Famoto/fetchbadge/case/preview.png

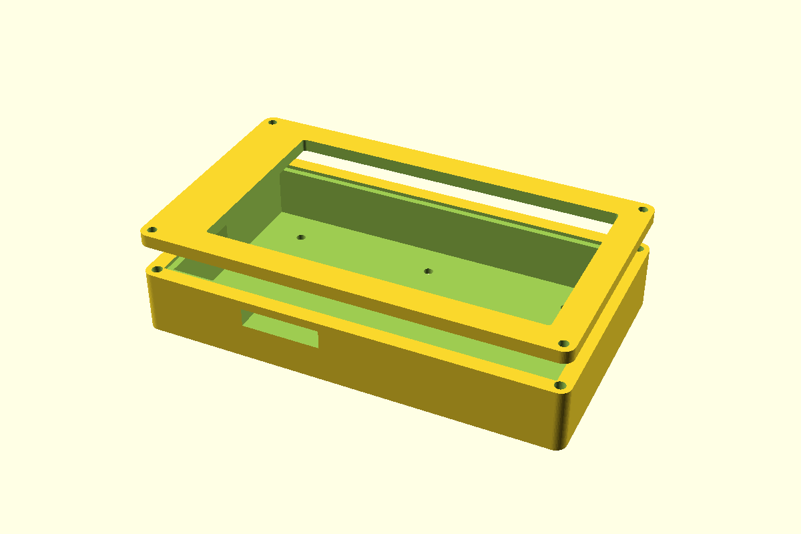
case/preview.png
