Famoto/fetchbadge/case/tray.stl

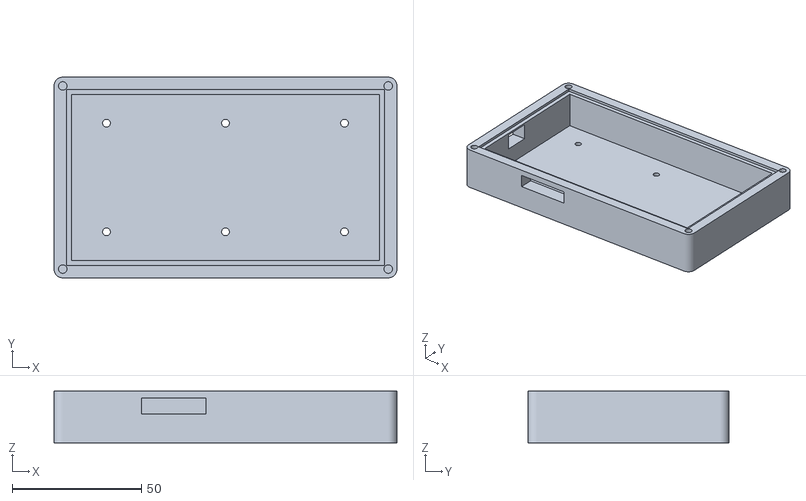
[picture p3: CAD file, 2026-10-25]
case/tray.stl
132.6 x 77.6 x 20.0
