Famoto/fetchbadge/case/bezel.stl

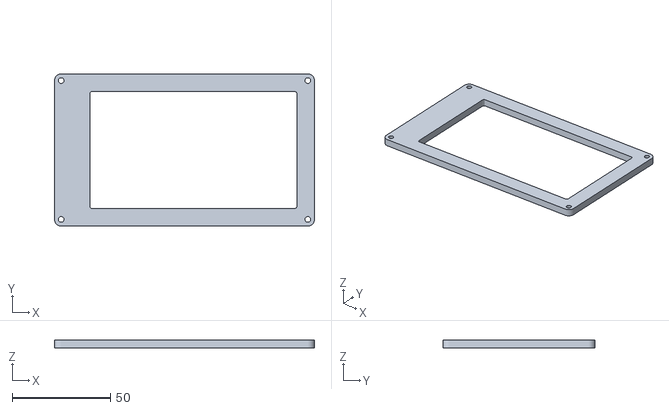
[picture p4: CAD file, 2026-10-25]
case/bezel.stl
132.6 x 77.6 x 4.00
