Famoto/fetchbadge/(commit log)

2026-10-15 dynamic battery update
2026-10-19 refactor: simplify view pipeline, merge power into hardware
    - Views are plain eager draw lists (`View { area, content }`); the lazy
    recipe layer (Rc<dyn Fn>, ElementSink, OnceCell) is gone. Views are
    rebuilt every wake anyway and building them costs microseconds against
    ~110 ms of fixed panel delays.
    - Drop dirty-bit tracking and the ViewMut drop guard: refresh compares
    all view signatures with the retained records, which was already the
    fallback path. `get_mut` returns `&mut View`.
    - Use Rectangle::is_zero_sized/zero, draw QR modules with fill_solid,
    move `overlaps` next to `covers`, remove a redundant battery branch.
    - Merge power.rs into hardware.rs, collect wake sources into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
2026-10-19 docs: split README into topic pages under docs/
    The README is now a short overview with a preview image, quick start,
    repository layout, and a table linking to firmware, configuration,
    architecture, testing, and case/parts pages. Content is moved, not
    rewritten; configuration gains a settings table.
    Claude-Session: https://claude.ai/code/session_01CvoWYhsfNY98TUXrcerWTY
2026-10-19 refactor: clear retained display state at boot instead of passing resume
    Power-on and RST must redraw fully even when RTC RAM survived. Board::new
    now clears the retained record for any wake that is not the button or
    timer, and the planner's existing "invalid record means full redraw" rule
    does the rest. The `resume` flag no longer travels through main,
    app::run, Pipeline::refresh, refresh::plan, or the tests.
    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
2026-10-19 feat: round the displayed battery reading to hide ADC noise
    The badge showed volts to 0.01 V, so ADC noise between hourly wakes
    redrew the battery row on most timer wakes. Readings now round to
    BATTERY_STEP_VOLTS (0.05 V), and the percentage is derived from the
    rounded voltage so both values change at the same threshold. Negative
    and NaN readings display as 0. The step is a config knob to tune against
    measured ADC jitter.
    Docs: describe the battery step, and that Board::new clears retained
    state on power-on and RST.
    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
2026-10-21 feat: LiPo discharge curve, RTC-safe display state, case v2
